barbhdez/GOGAIT/README.md

# GOGAIT

Wearable gait-analysis system based on instrumented insoles with plastic optical fiber (POF) sensors, developed as a Bachelor's Thesis — *"Gait Analysis and Visualization Using a Smart Optical Fiber Insole for Injury Prevention"* (Telecommunications Engineering, Universidad Carlos III de Madrid).












<p align="center">
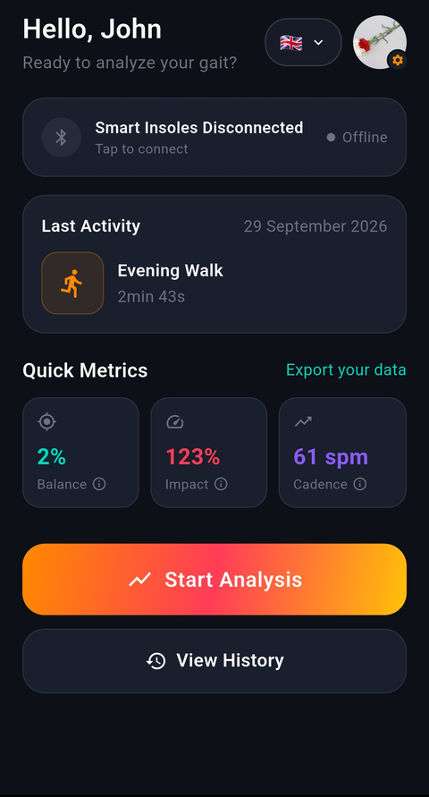
[picture p1: docs/screenshots_en/home_en.png]
Home screen
  
  &nbsp;&nbsp;
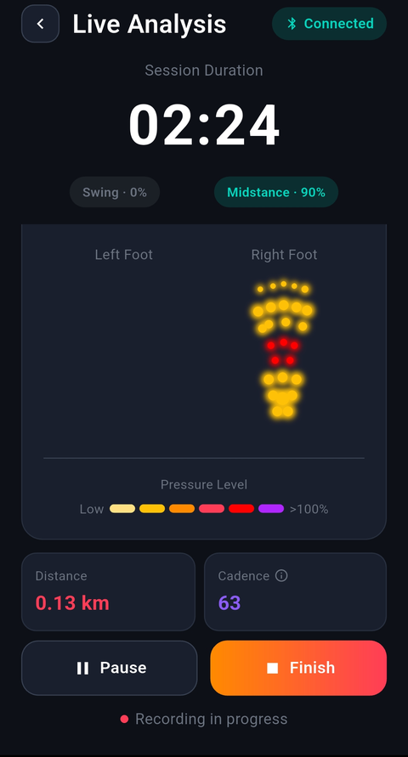
[picture p2: docs/screenshots_en/hero_analisis_vivo_en.png]
Live analysis with plantar pressure heatmap
  
</p>

## Description

GOGAIT integrates two instrumented insoles (one per foot) with their acquisition and Bluetooth Low Energy transmission electronics, and this Flutter mobile app, which:

- Manages user profiles and the individual calibration of each insole.
- Receives plantar pressure readings over BLE in real time.
- Generates dynamic heatmaps of the pressure distribution.
- Computes biomechanical metrics: Balance, Impact, Fatigue Index, Performance Score, Stride Ratio, and Strike Index.
- Keeps a session history and lets you export the data as CSV.

<table align="center">
  <tr>
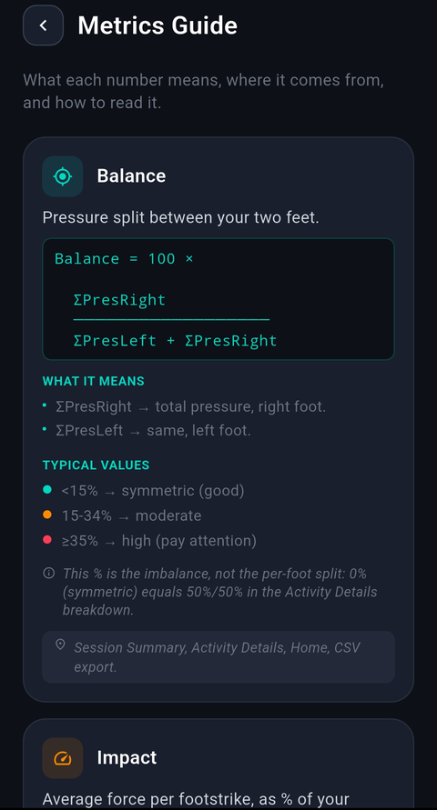
[picture p3: docs/screenshots_en/guia_equilibrio_en.png]
Metrics guide: Balance explanation
    <td align="center"></td>
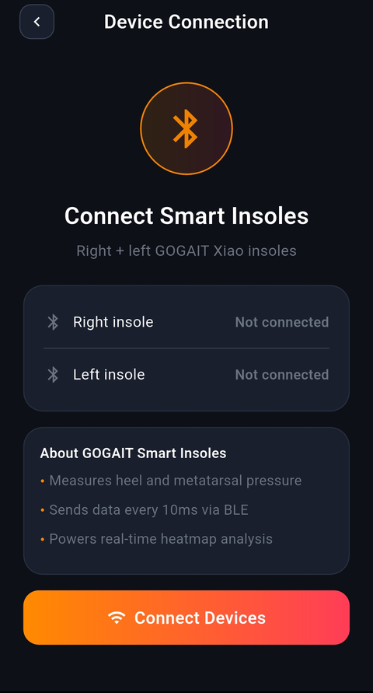
[picture p4: docs/screenshots_en/bluetooth_en.png]
Bluetooth connection with the insole
    <td align="center"></td>
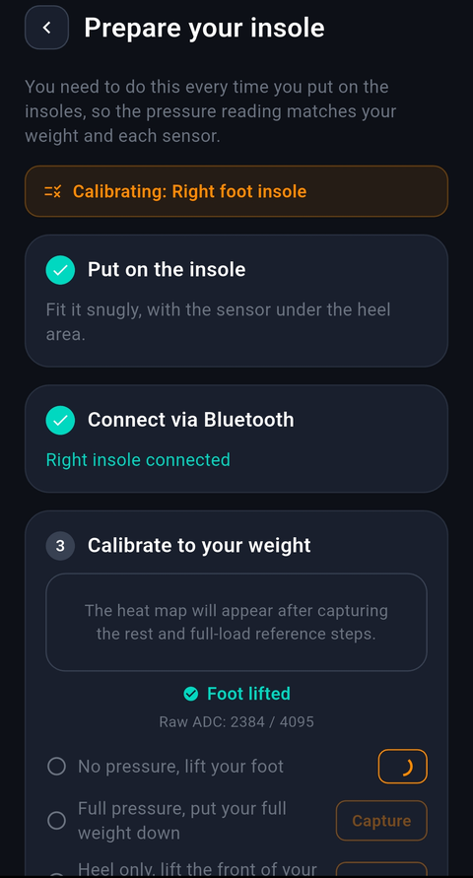
[picture p5: docs/screenshots_en/calibracion_en.png]
Guided calibration of the insole
    <td align="center"></td>
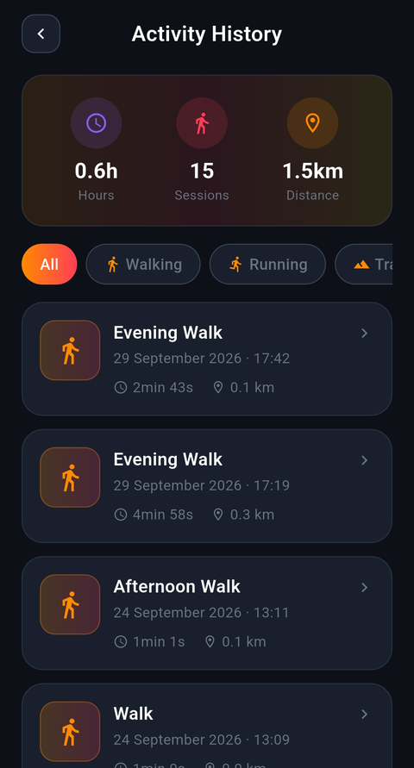
[picture p6: docs/screenshots_en/historial_en.png]
Activity history
    <td align="center"></td>
  </tr>
  <tr>
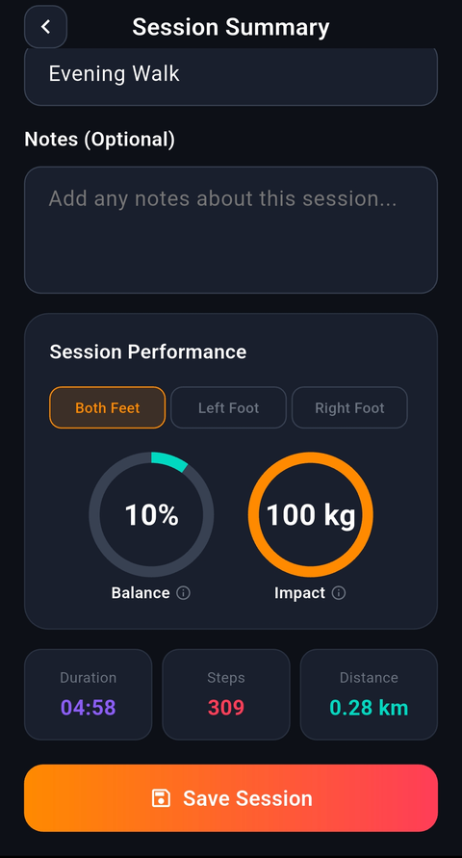
[picture p7: docs/screenshots_en/resumen_sesion_en.png]
Session summary
    <td align="center"></td>
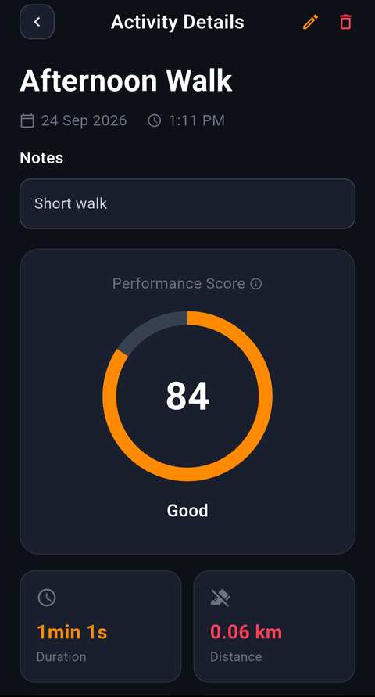
[picture p8: docs/screenshots_en/detalles_actividad_en.png]
Activity details
    <td align="center"></td>
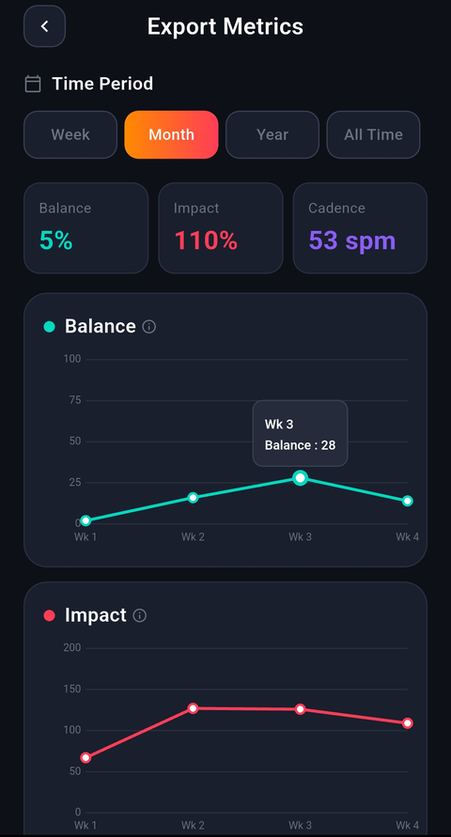
[picture p9: docs/screenshots_en/quick_metrics_en.png]
Quick metrics / trend across sessions
    <td align="center"></td>
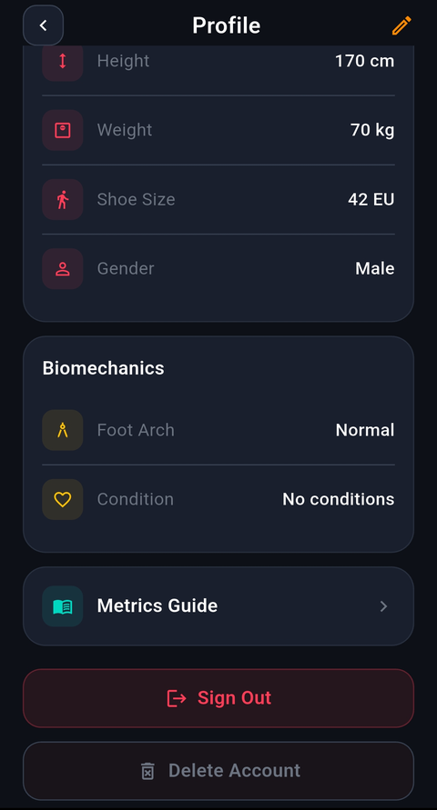
[picture p10: docs/screenshots_en/perfil_en.png]
User profile
    <td align="center"></td>
  </tr>
</table>

## Architecture

<p align="center">
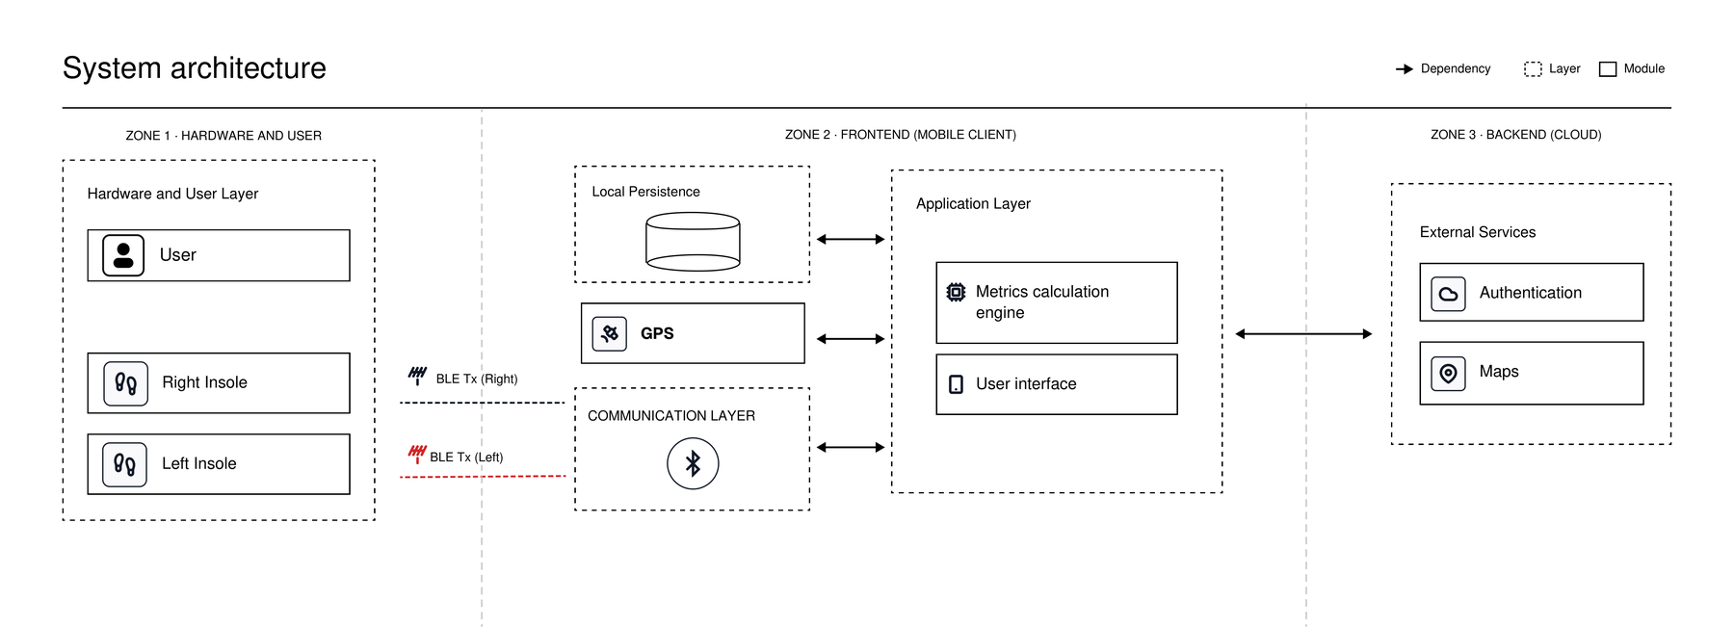
[picture p11: docs/arquitectura.png]
System architecture: hardware and user, mobile client, and backend
  
</p>

The instrumented insoles transmit over BLE to the mobile client, which handles all the processing and keeps the history stored locally. The cloud is limited to user authentication and the map tiles used for the route; there is no dedicated backend server or remote database.

### Hardware

<p align="center">
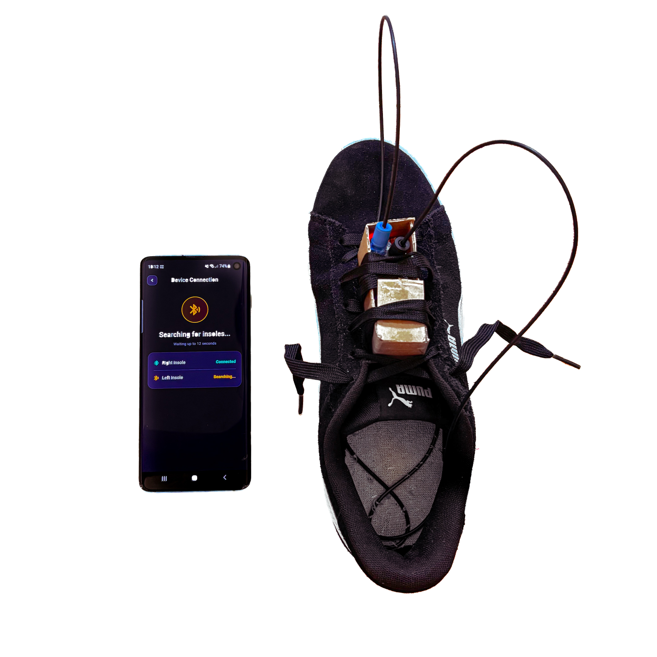
[picture p12: docs/foto-plantilla-sensorizada.png]
Instrumented shoe with the full sensing and acquisition system mounted
  
</p>
<p align="center"><i>The complete system mounted on the shoe: the POF sensor fiber routed through the insole, and the acquisition PCB (XIAO nRF52840, signal conditioning, BLE connector) and LiPo battery on the tongue.</i></p>

<p align="center">
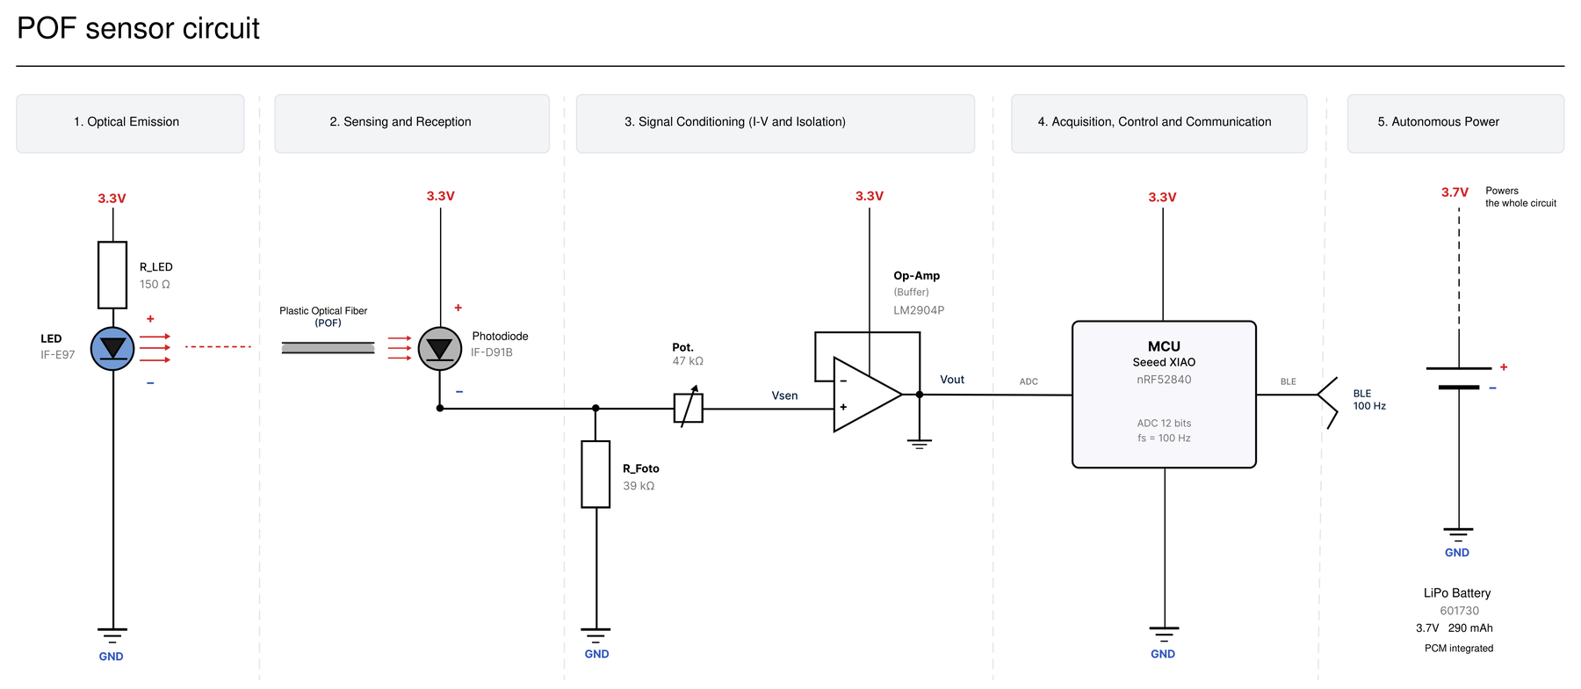
[picture p13: docs/diagrama-circuito-pof.png]
POF sensor circuit: optical emission, photodiode reception, signal conditioning, acquisition and BLE, autonomous power
  
</p>
<p align="center"><i>The 5 stages of the sensing circuit: a 650 nm LED (IF-E97) emits light through the fiber, a photodiode (IF-D91B) receives it, an op-amp (LM2904P) conditions the signal, the XIAO nRF52840 digitizes it with its 12-bit ADC and sends it over BLE, powered by a 3.7 V / 290 mAh LiPo battery.</i></p>

<p align="center">
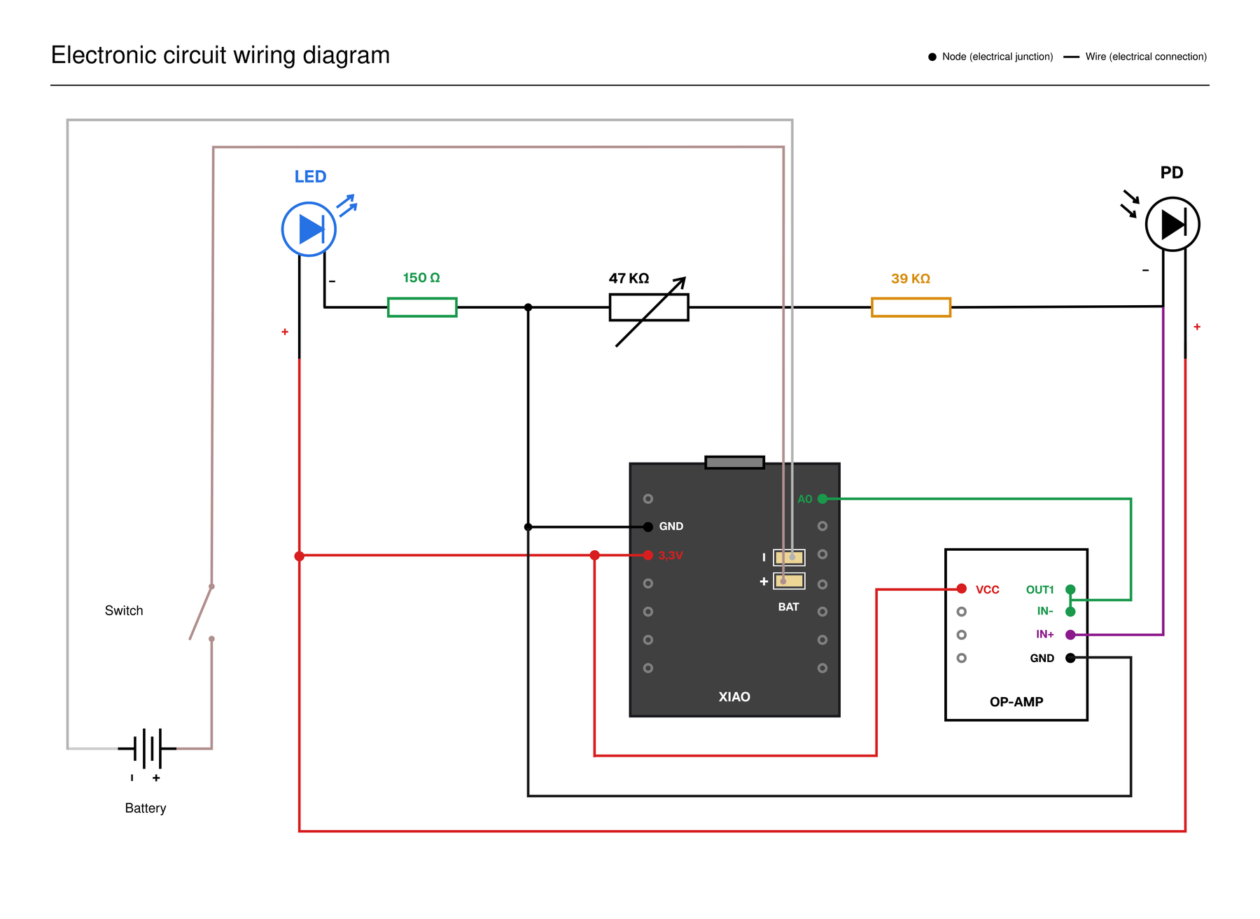
[picture p14: docs/diagrama-conexion-electronica.png]
Wiring diagram of the electronic components
  
</p>
<p align="center"><i>Real wiring between the LED, photodiode, resistors, op-amp and the XIAO board.</i></p>

<p align="center">
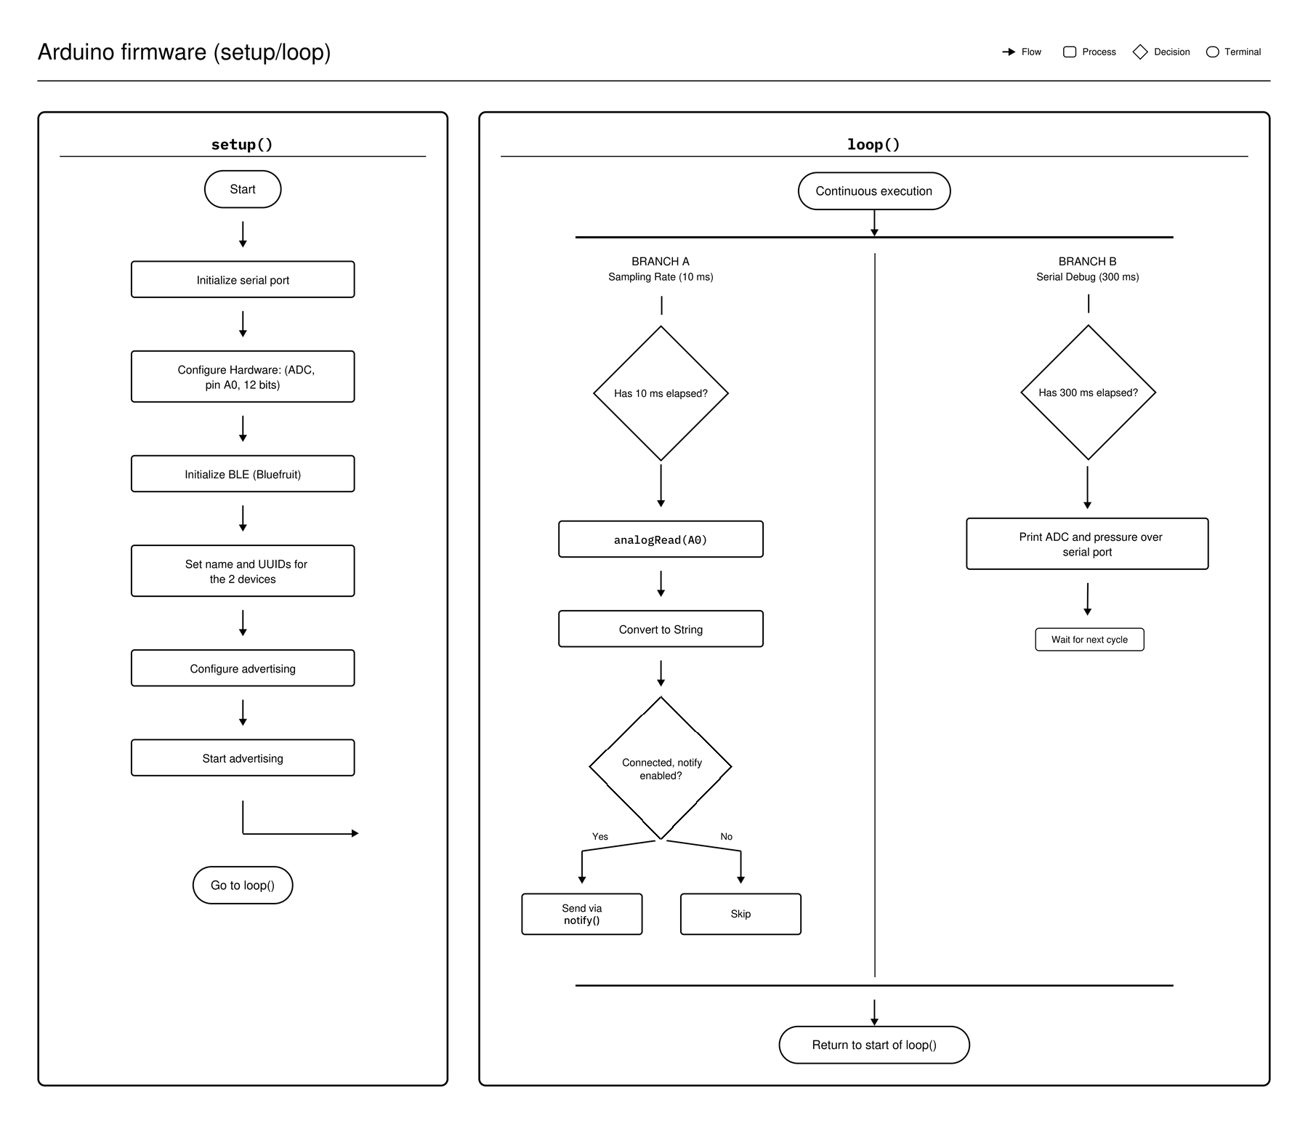
[picture p15: docs/diagrama-firmware.png]
Firmware flow diagram: setup and loop
  
</p>
<p align="center"><i>Firmware structure: <code>setup()</code> initializes BLE and the sensor pins once; <code>loop()</code> samples the ADC every 10 ms and pushes the reading over BLE.</i></p>

<p align="center">
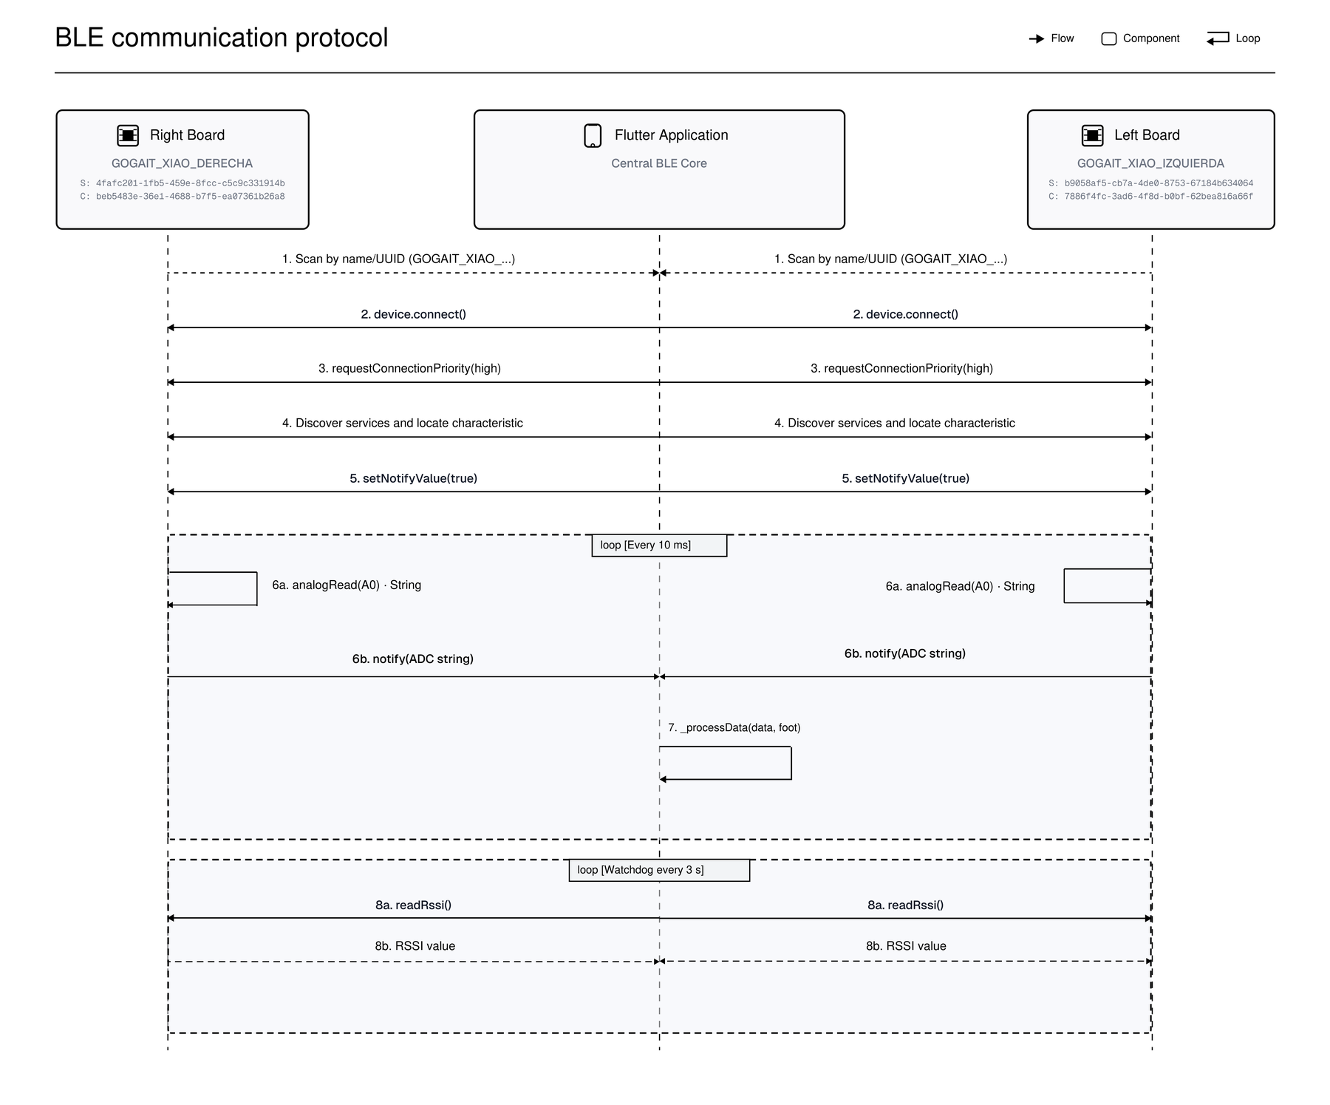
[picture p16: docs/diagrama-protocolo-ble.png]
BLE communication protocol sequence diagram
  
</p>
<p align="center"><i>Each insole exposes its own BLE service and characteristic (GATT). After scanning, connecting and enabling notifications, each board pushes a sample every 10 ms; a 3-second RSSI read acts as a connection watchdog.</i></p>

### Software

<p align="center">
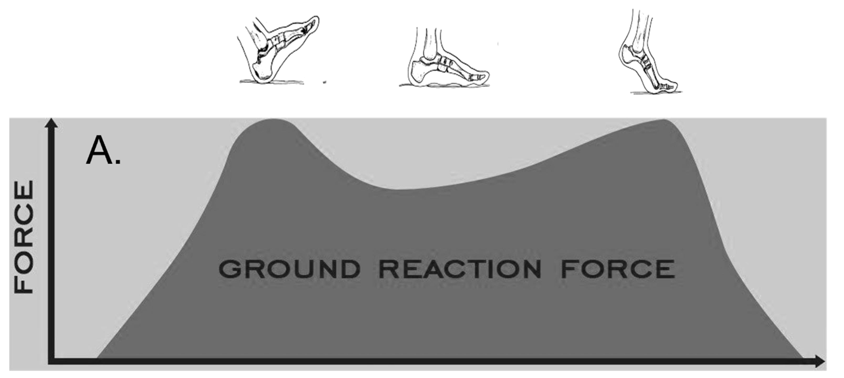
[picture p17: docs/diagrama-curva-m.png]
M-shaped ground reaction force curve during stance phase
  
</p>
<p align="center"><i>The ground reaction force during stance draws an "M" shaped curve, with peaks at heel strike and propulsion — the reason GOGAIT places its two sensing zones at the heel and the metatarsal area.</i></p>

<p align="center">
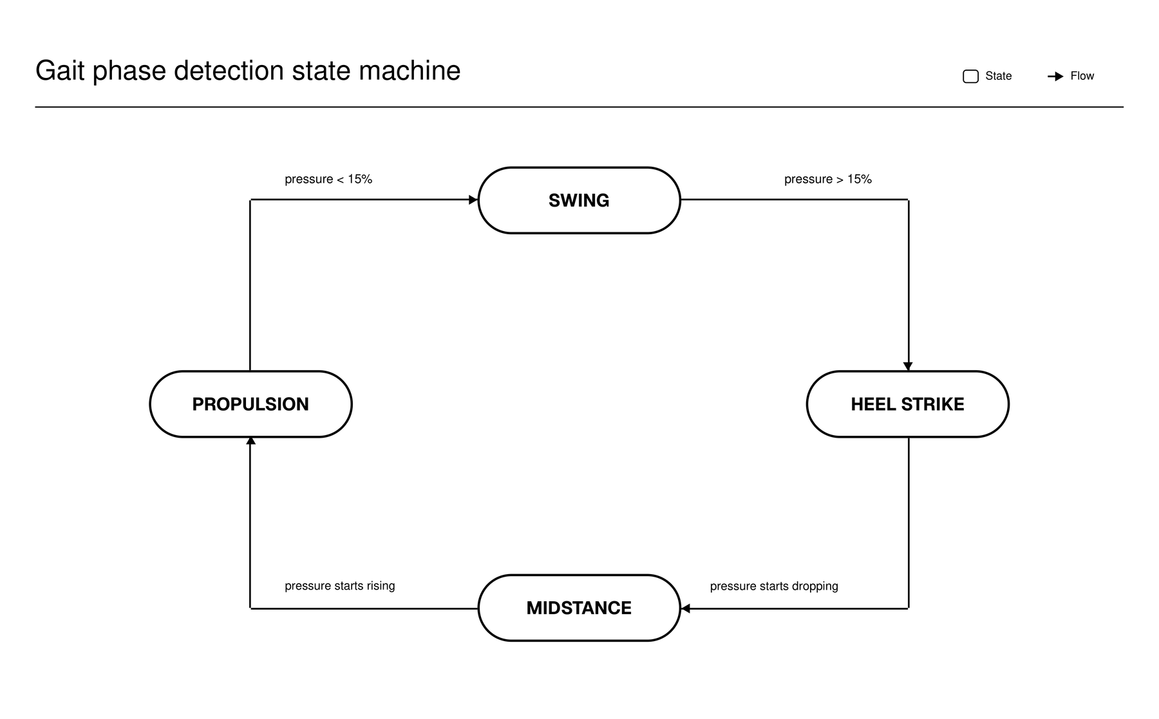
[picture p18: docs/diagrama-maquina-estados-fase.png]
State machine for gait phase detection
  
</p>
<p align="center"><i>The app detects Heel Strike, Midstance, Propulsion and Swing purely in software, by comparing the pressure signal against a contact threshold and its trend, with no extra sensors.</i></p>

<p align="center">
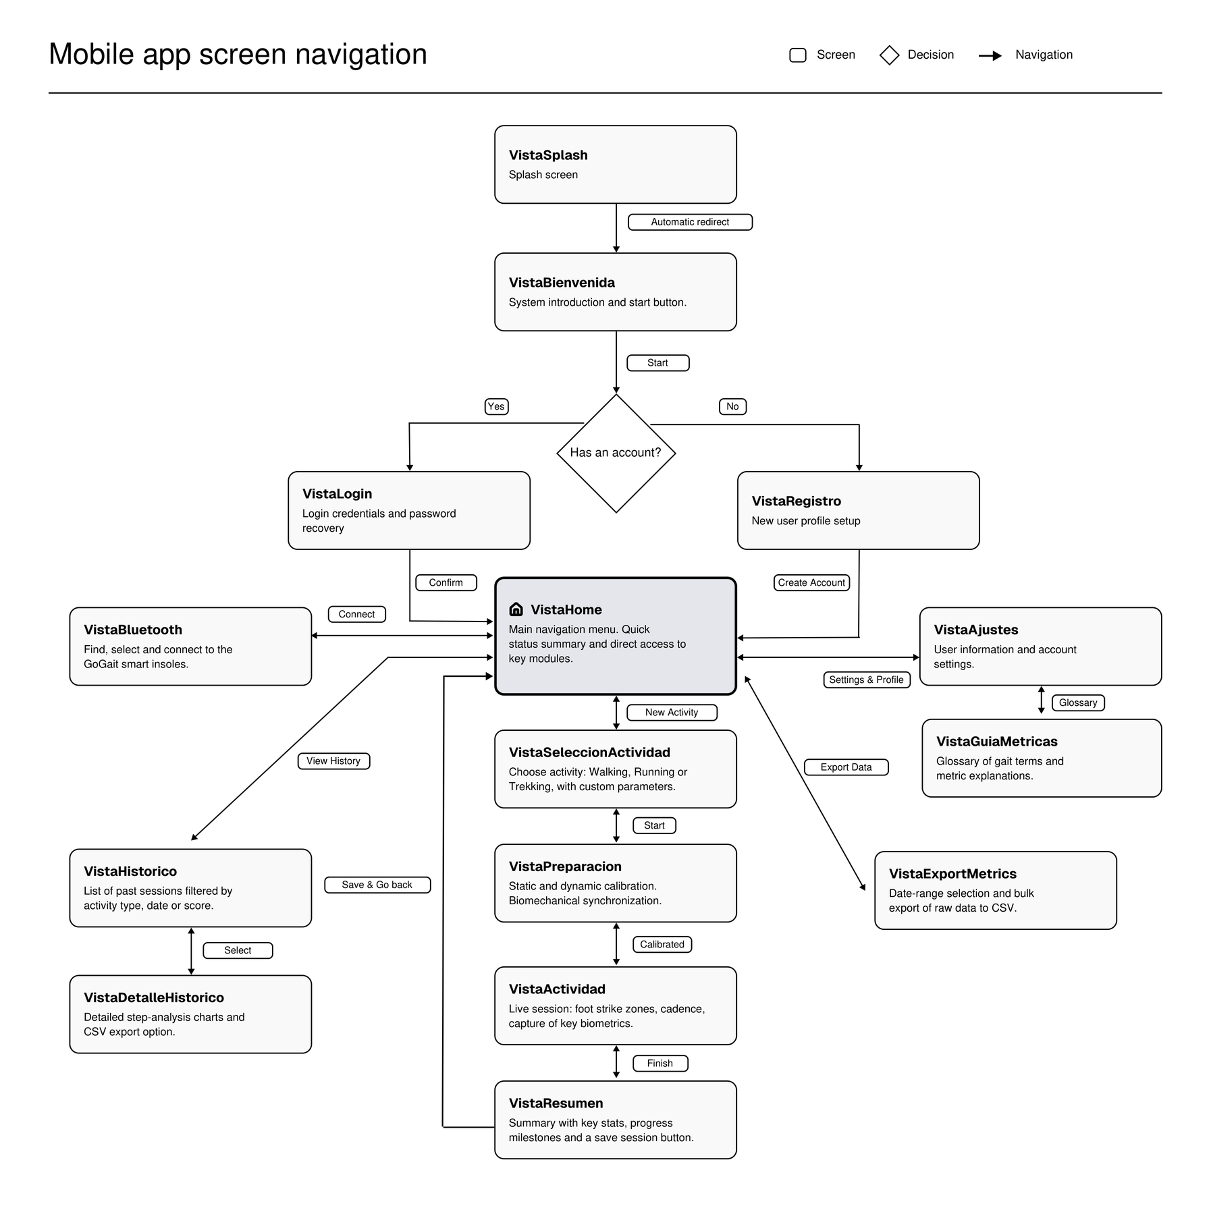
[picture p19: docs/diagrama-navegacion-pantallas.png]
Screen navigation flow of the mobile app
  
</p>
<p align="center"><i>How a user moves through the app: connect the insoles over BLE, calibrate both feet, run the activity with the live heatmap, and review it afterward from the session summary or the history.</i></p>

<p align="center">
  Calibration state machine for walking and running/trekking
</p>
<p align="center"><i>Guided calibration sequence, with a shorter 4-step path for walking and a longer 7-step path for running/trekking, repeated for each foot.</i></p>

<p align="center">
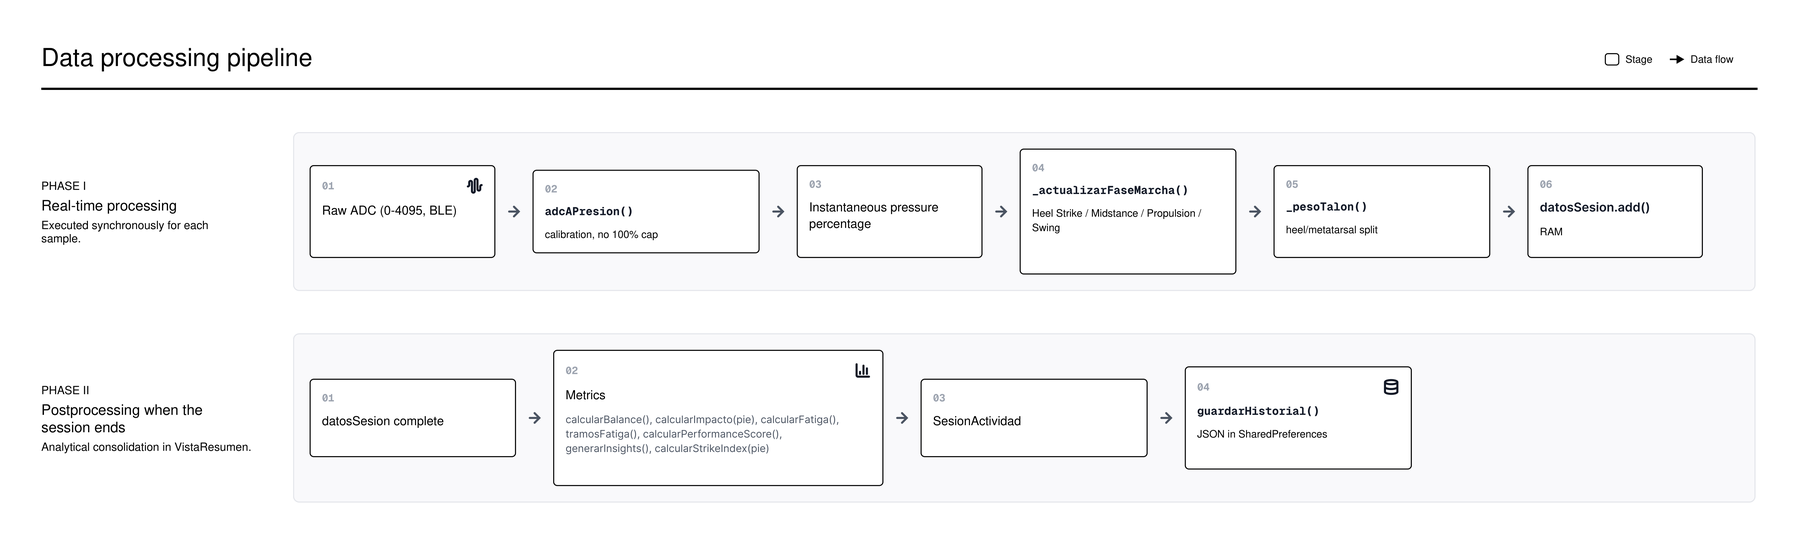
[picture p20: docs/diagrama-pipeline-datos.png]
Data processing pipeline: real-time stage and end-of-session postprocessing
  
</p>
<p align="center"><i>Each sample goes through the real-time stage (pressure, phase, heatmap) as it arrives; the 7 metrics are only computed once, in a postprocessing stage, when the session ends.</i></p>

<p align="center">
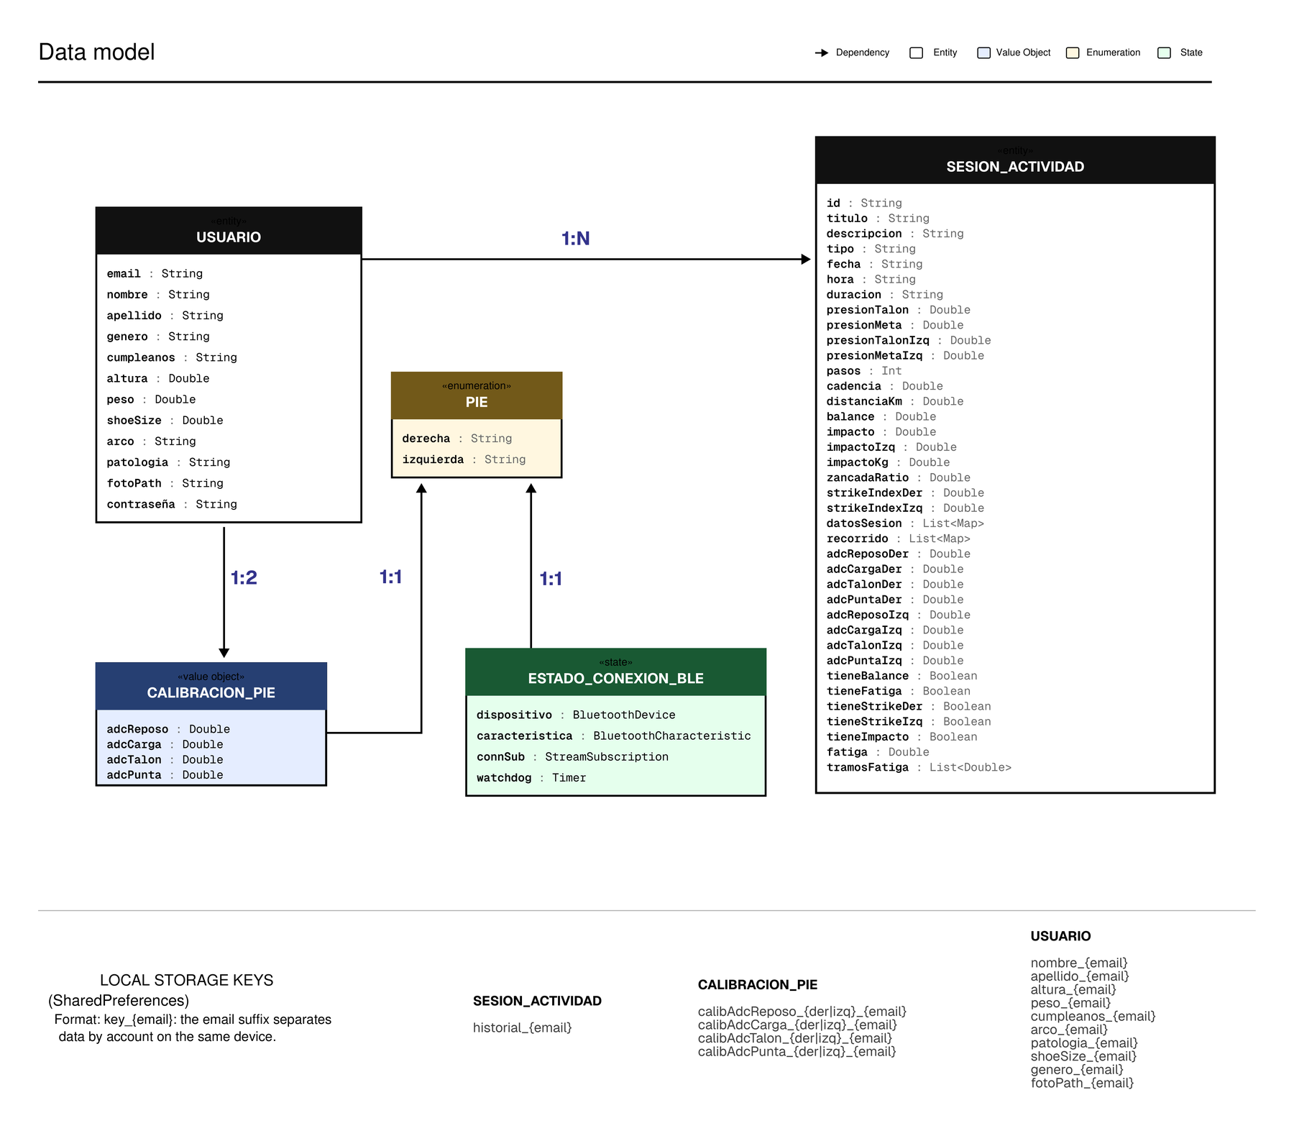
[picture p21: docs/diagrama-modelo-datos.png]
Data model: Usuario, SesionActividad, Calibracion_Pie, Estado_Conexion_BLE entities and their relationships
  
</p>
<p align="center"><i>Local data model: a user owns a calibration per foot and a history of activity sessions; the BLE connection state is kept separately and never persisted. Everything is namespaced by email in <code>SharedPreferences</code>, so several accounts can share the same device.</i></p>

<p align="center">
  Use case diagram of the system
</p>
<p align="center"><i>What a user can do with GOGAIT: register, pair the insoles, calibrate, run an activity, review the session history, and manage their profile.</i></p>

### Results

<p align="center">
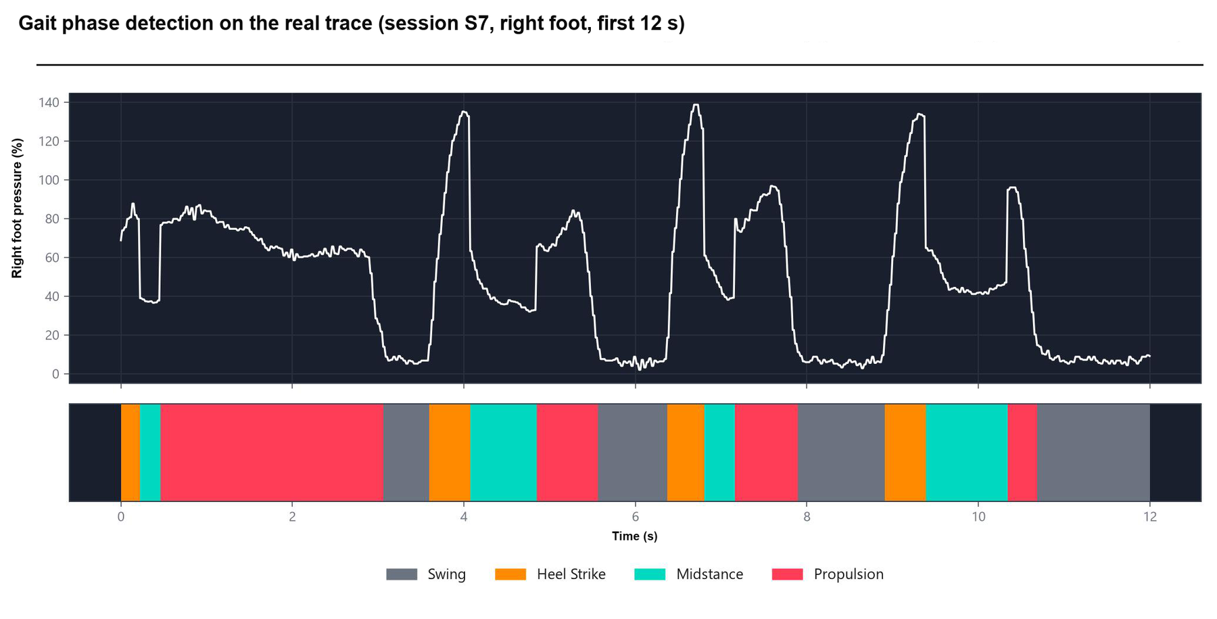
[picture p22: docs/resultado-traza-fase-s7.png]
Gait phase detection over a real pressure trace, session S7
  
</p>
<p align="center"><i>Phase detection running on a real recorded trace (session S7, first 12 s): Swing lines up with the pressure valleys, and Heel Strike marks the sharp rise at the start of each peak.</i></p>

<p align="center">
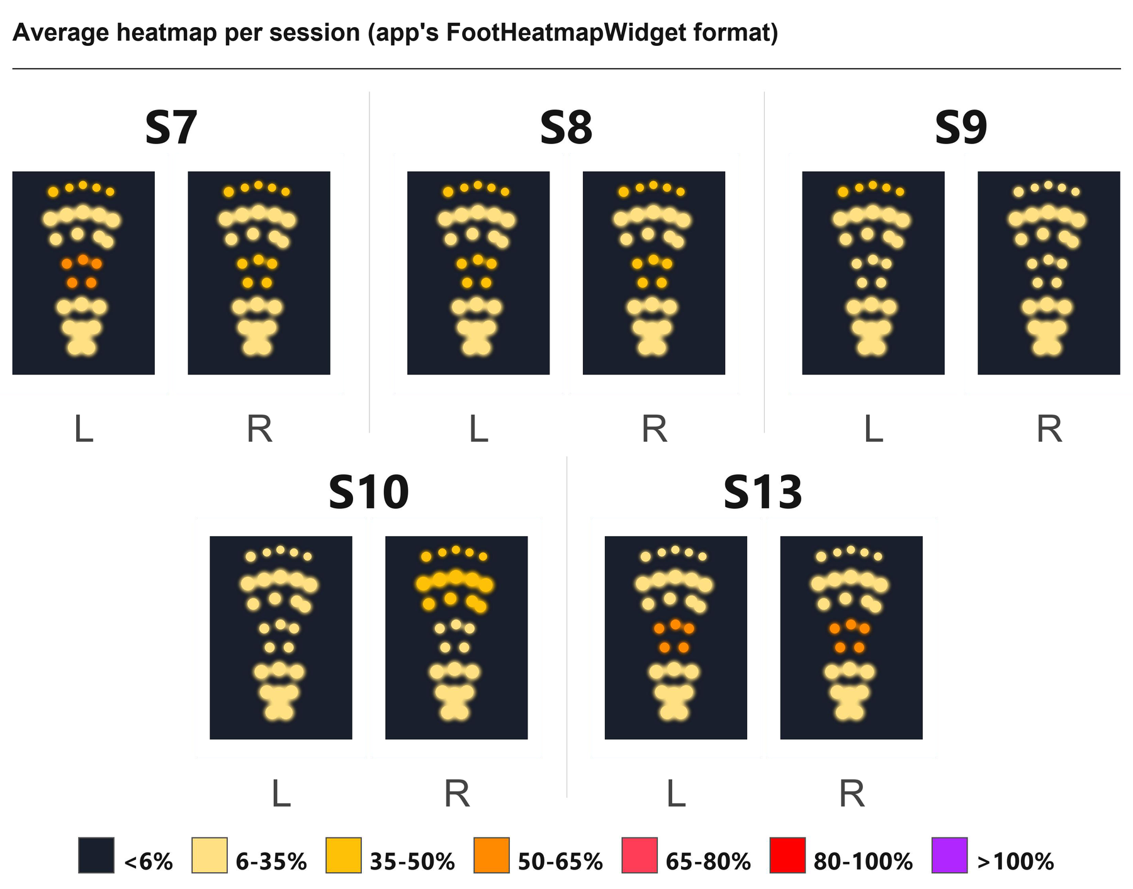
[picture p23: docs/resultado-mapa-calor-promedio.png]
Averaged plantar pressure heatmap across 5 validated sessions
  
</p>
<p align="center"><i>Heatmap averaged over the 5 validated sessions (same color scale as the app), showing a consistent forefoot-dominant loading pattern in both feet.</i></p>

## Project structure

```
lib/
├── main.dart          # entry point: imports, app setup and routing
├── core/              # theme (colors, gradients, transitions) and BLE IDs per insole
├── i18n/              # translations (EN, ES, FR, DE, IT, PT)
├── models/            # Usuario, SesionActividad
├── logic/             # biomechanical metrics (balance, impact, fatigue, strike index...)
├── services/          # BLE connection + calibration, local persistence (SharedPreferences)
├── utils/             # date helpers and form validators
├── widgets/           # shared widgets, foot heatmap, GPS route map
└── screens/           # one file per screen (login, home, live activity, history...)
firmware/
├── GOGAIT_XIAO_DERECHA/     # Arduino sketch, right insole
└── GOGAIT_XIAO_IZQUIERDA/   # Arduino sketch, left insole
docs/                  # diagrams, results and screenshots used in this README
```

The files under `lib/` are Dart `part`s of `main.dart`, so they share the same library scope.

The firmware for each Seeed Studio XIAO nRF52840 is written in Arduino (C++) with the Adafruit Bluefruit nRF52 library, and the UI was designed in Figma.

## Requirements

- Flutter SDK (stable channel).
- A physical Android device: BLE communication and GPS do not work on the emulator.
- Your own Firebase project (Authentication) — `firebase_options.dart` and credentials are not included in this repository.

## Authorship

Bárbara Cristina Hernández Bello — Telecommunications Engineering, Universidad Carlos III de Madrid (2026).

Supervisors: Alicia Fresno Hernández, Carmen Vázquez García.
