barbhdez/GOGAIT/assets/mesh-bg.jpg

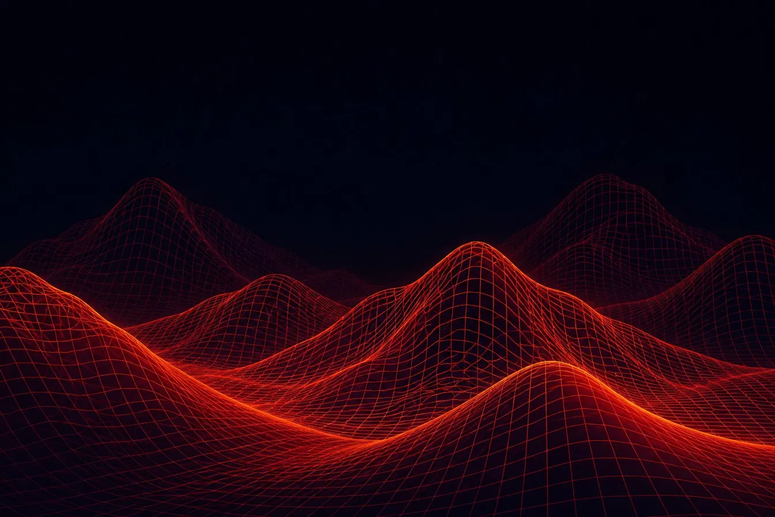
assets/mesh-bg.jpg
