barbhdez/GOGAIT/docs/diagrama-casos-de-uso_v2.png

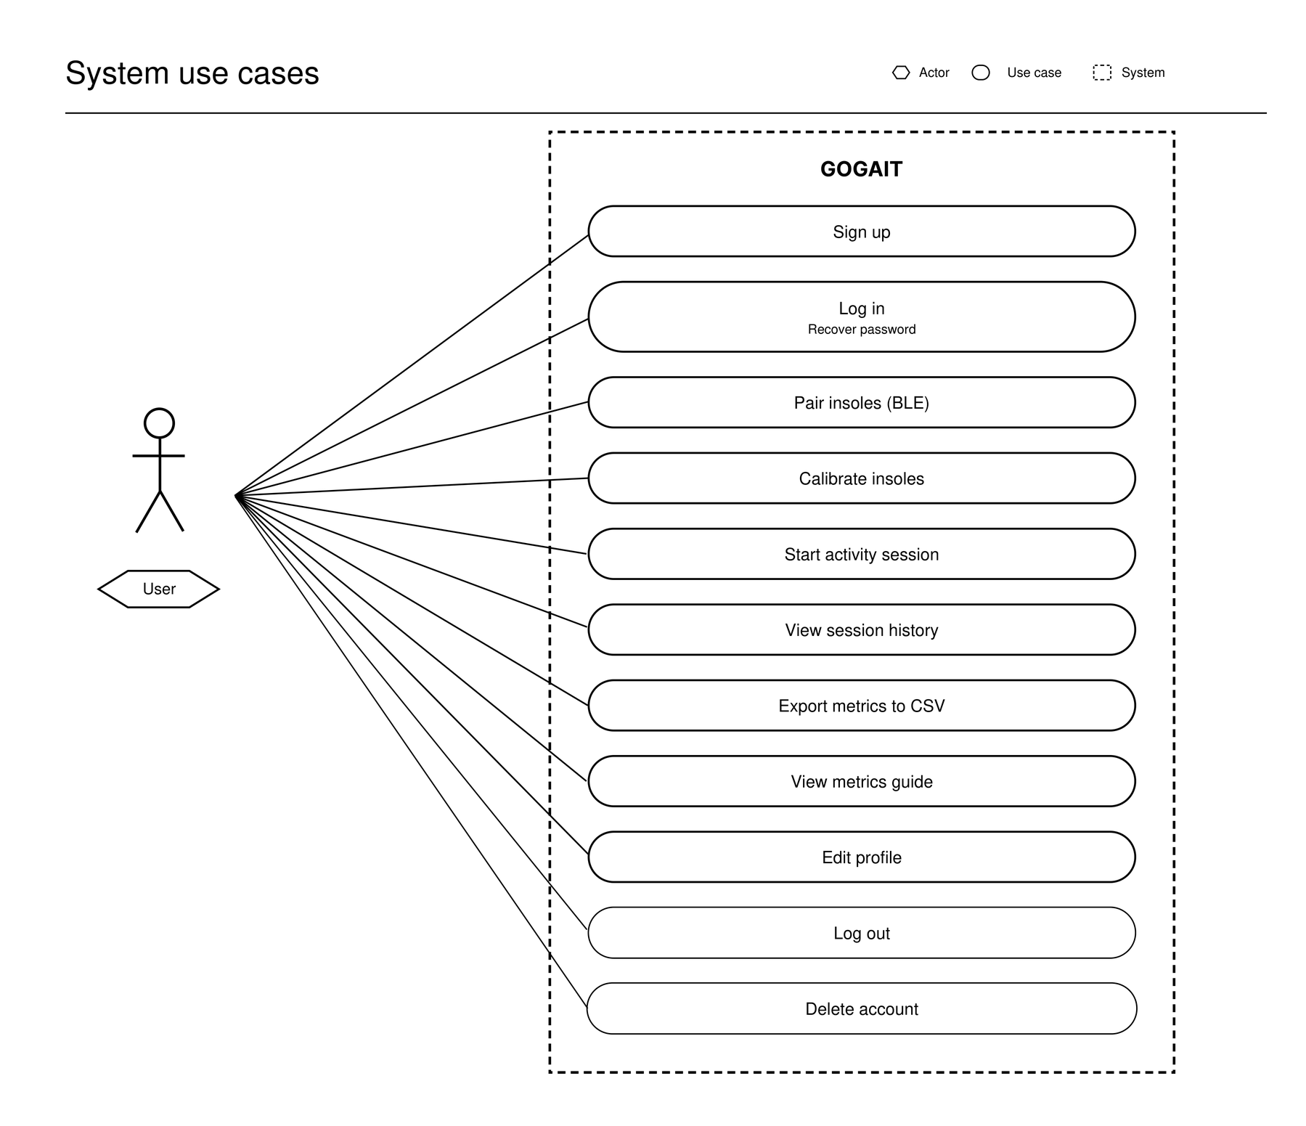
docs/diagrama-casos-de-uso_v2.png
