barbhdez/GOGAIT/docs/screenshots/bluetooth_v2.png

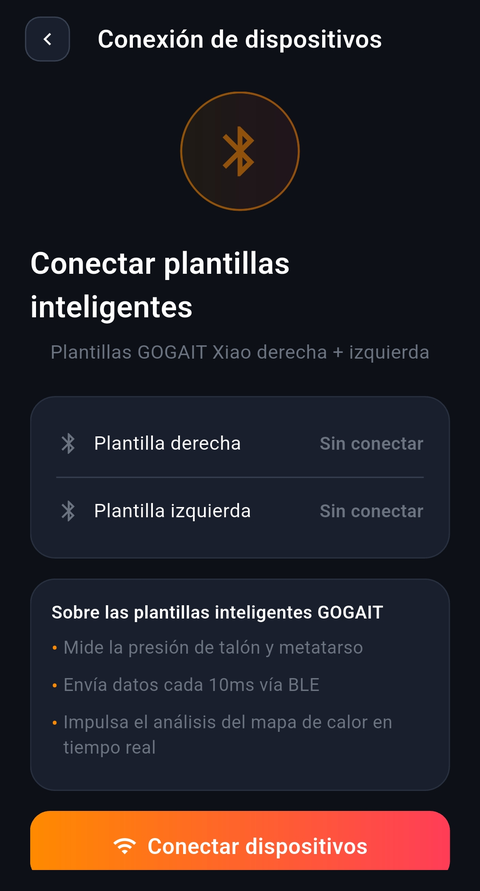
docs/screenshots/bluetooth_v2.png
