barbhdez/GOGAIT/docs/screenshots/detalles_actividad_v2.png

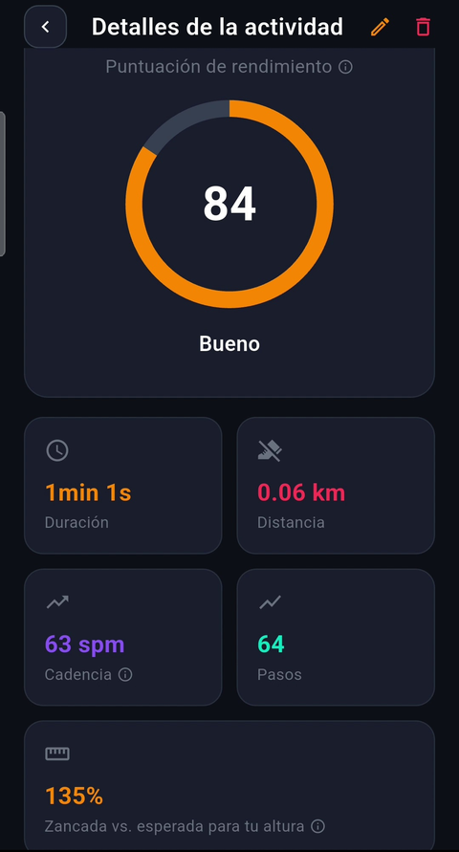
docs/screenshots/detalles_actividad_v2.png
