barbhdez/GOGAIT/docs/screenshots/guia_equilibrio_v2.png

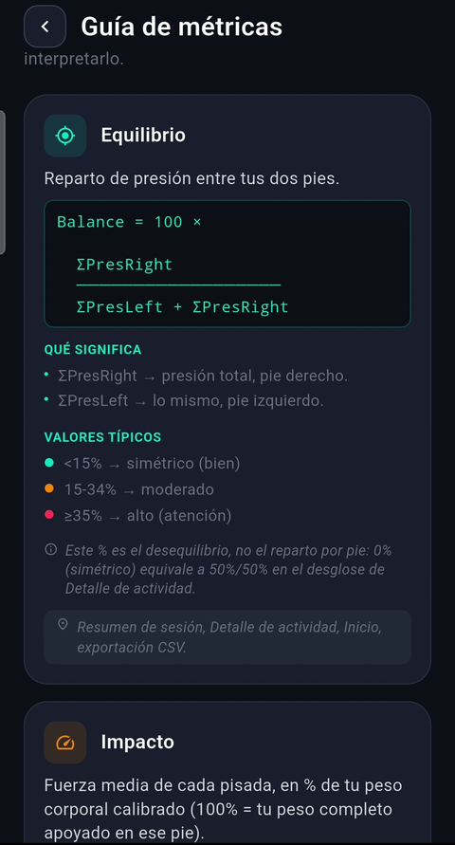
docs/screenshots/guia_equilibrio_v2.png
