barbhdez/GOGAIT/docs/screenshots/hero_analisis_vivo_v2.png

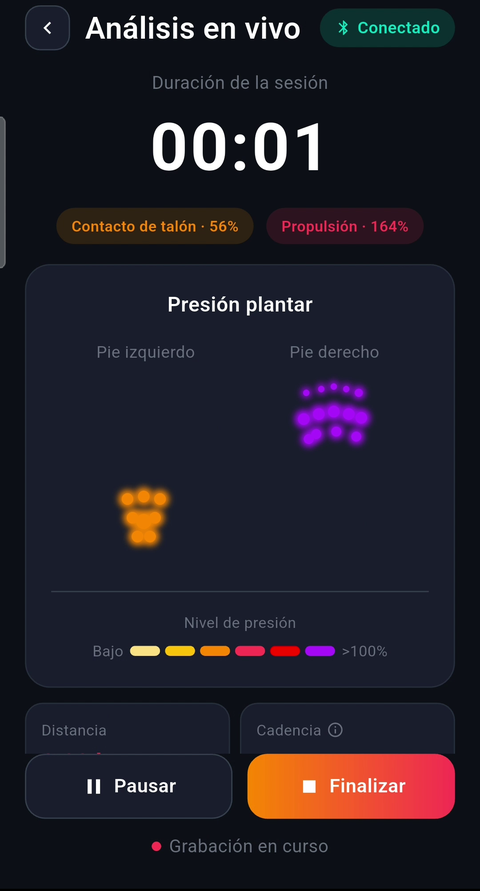
docs/screenshots/hero_analisis_vivo_v2.png
