barbhdez/GOGAIT/docs/screenshots/quick_metrics_v2.png

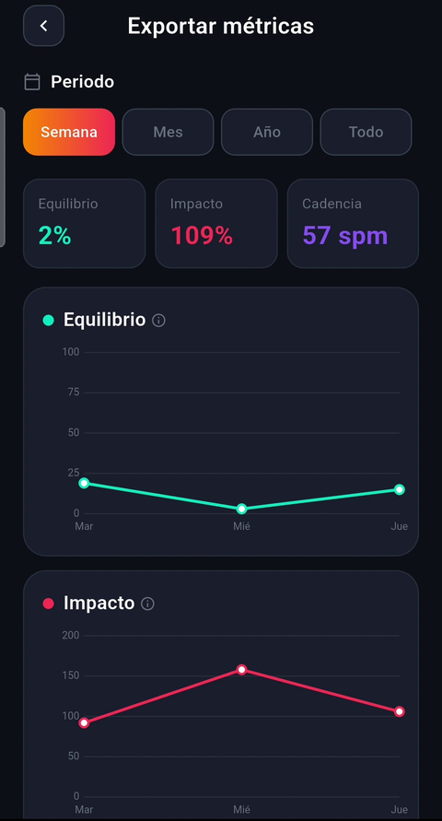
docs/screenshots/quick_metrics_v2.png
