barbhdez/GOGAIT/docs/screenshots_es/historial_es.png

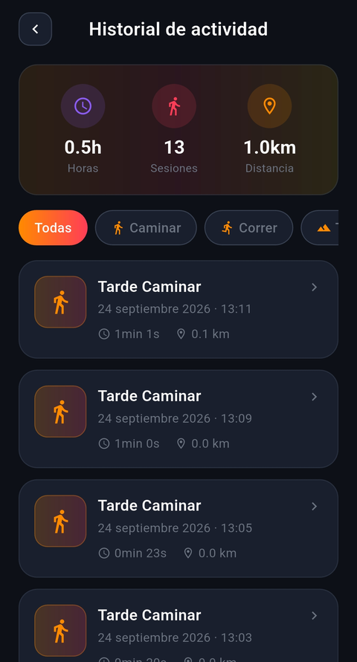
docs/screenshots_es/historial_es.png
