barbhdez/GOGAIT/docs/screenshots_es/home_es.png

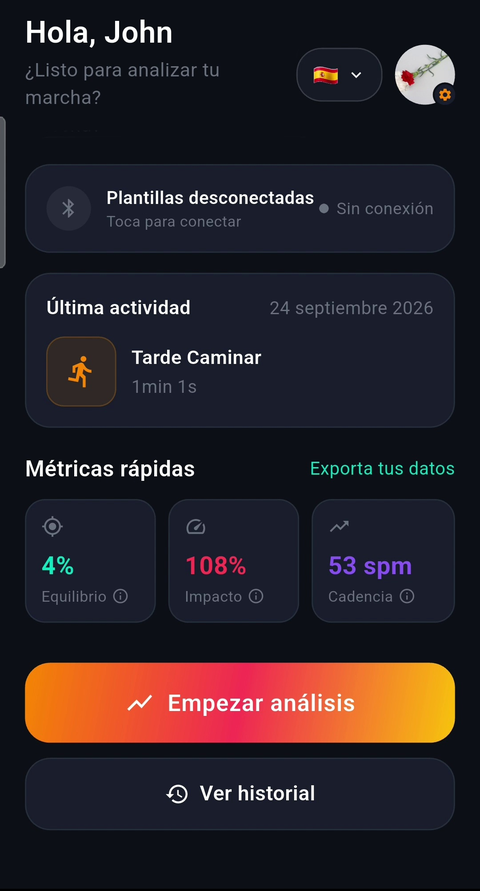
docs/screenshots_es/home_es.png
