barbhdez/GOGAIT/docs/screenshots_es/perfil_es.png

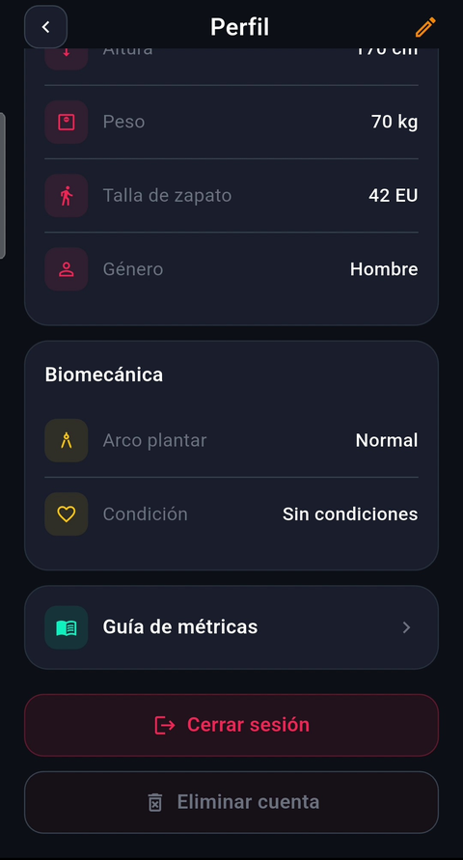
docs/screenshots_es/perfil_es.png
