barbhdez/GOGAIT/docs/screenshots_es/resumen_sesion_v2.png

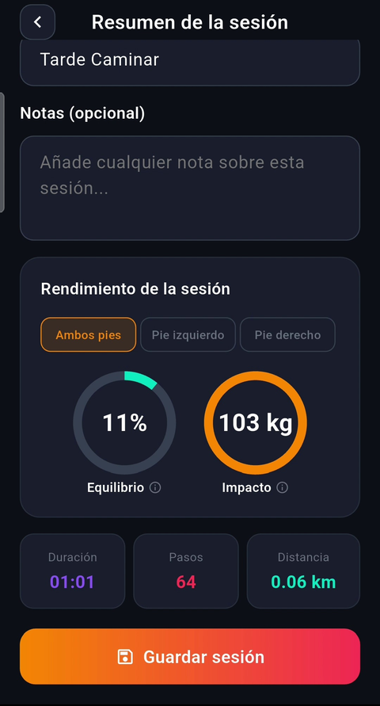
docs/screenshots_es/resumen_sesion_v2.png
