barbhdez/GOGAIT/docs/social_preview.png

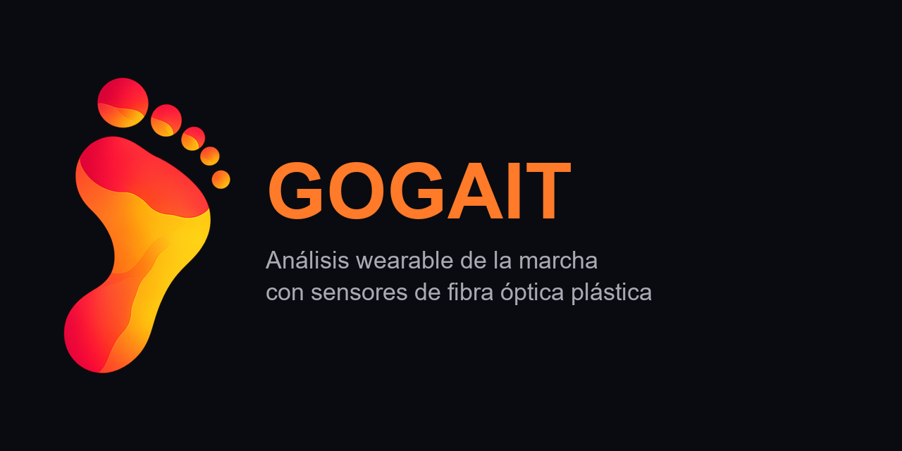
docs/social_preview.png
