barbhdez/GOGAIT/docs/diagrama-maquina-estados-calibracion_v2.png

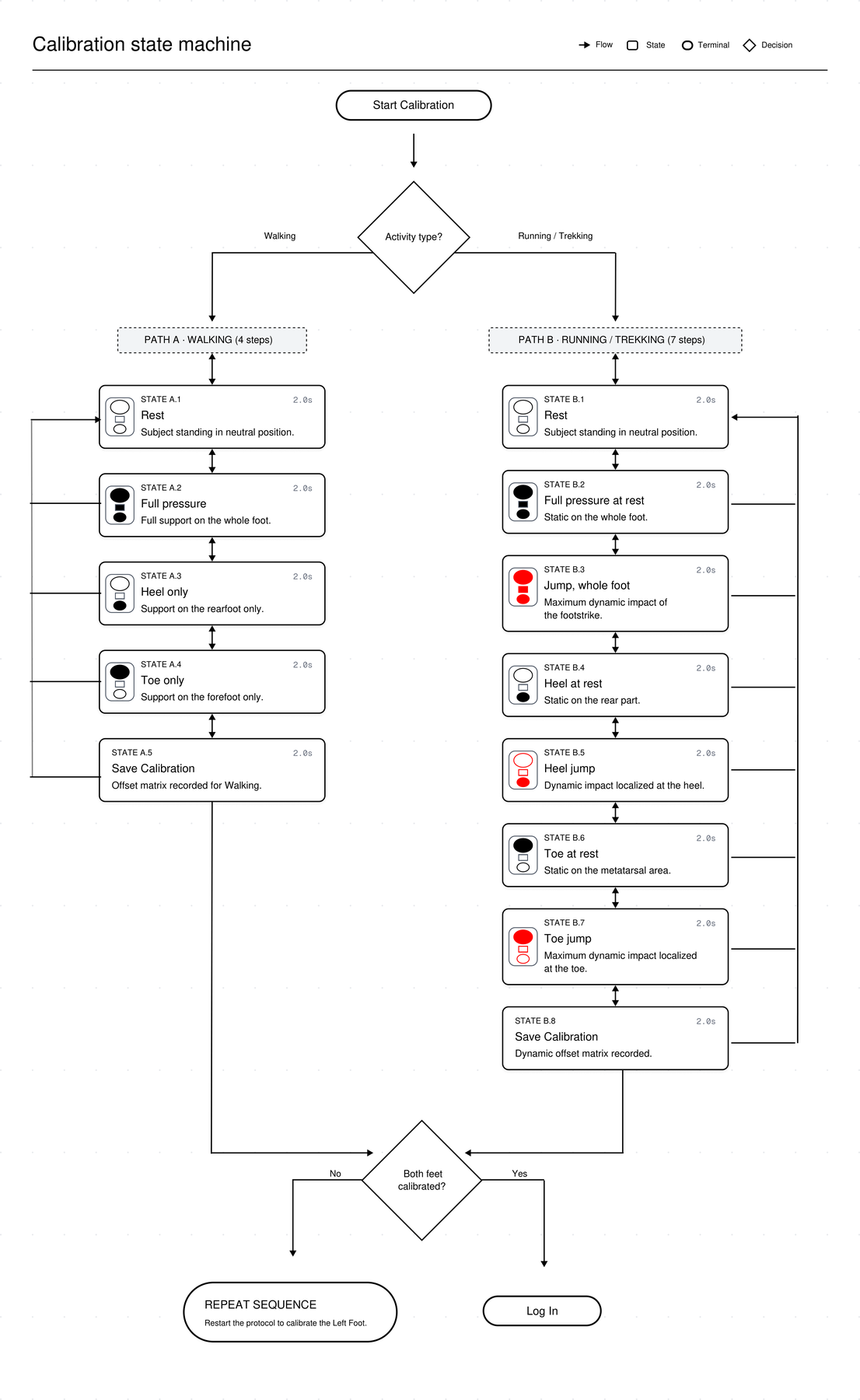
docs/diagrama-maquina-estados-calibracion_v2.png
