barbhdez/GOGAIT/docs/screenshots_es/calibracion_v2.png

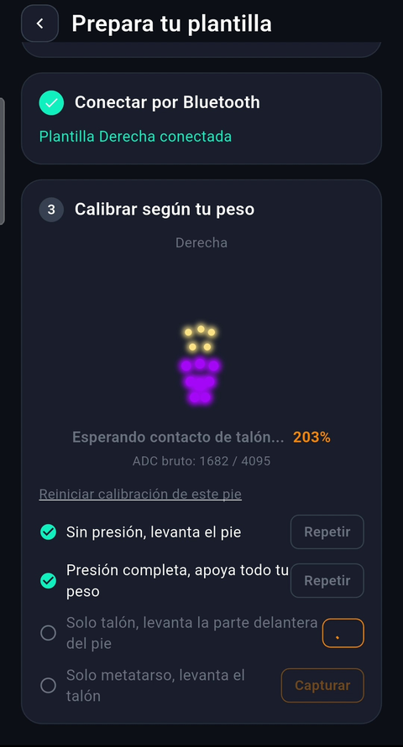
docs/screenshots_es/calibracion_v2.png
