barbhdez/GOGAIT/(commit log)

2026-09-29 GOGAIT — Gait Analysis and Visualization Using a Smart Optical Fiber Insole for Injury Prevention
    Wearable gait-analysis system made up of two instrumented insoles with plastic optical fiber (POF) sensors, acquisition and Bluetooth Low Energy transmission electronics (Seeed XIAO nRF52840), and a cross-platform Flutter mobile app that receives the signal in real time, generates dynamic heatmaps, detects the phases of the gait cycle, and computes seven biomechanical metrics (Balance, Impact, Fatigue Index, Performance Score, Stride Ratio, Strike Index, and Cadence) aimed at injury prevention.
    [GOGAIT_XIAO_DERECHA.ino, GOGAIT_XIAO_IZQUIERDA.ino]
2026-10-02 Add architecture, hardware, software and results documentation to README
    Adds 13 diagrams (architecture, circuit, wiring, firmware, BLE
    protocol, gait-phase curve and state machine, screen navigation,
    calibration, data pipeline, data model, use cases, phase-detection
    trace, averaged heatmap) plus a photo of the fully sensorized shoe,
    all translated to English and organized under new Hardware, Software
    and Results subsections.
2026-10-27 Split main.dart into modules and add tech badges to README
    - Split lib/main.dart into part files: core, i18n, models, logic,
    services, utils, widgets and one file per screen.
    - README: Arduino, C++, Android, OpenStreetMap and Figma badges, and
    updated project structure.
    - Update pubspec description.
